v-process/DroneProject/STM32F103RET6/SLAVE_WIFI&UltraSonic/User_GPIO.c

#include "main.h"

void RCC_Configuration(void){
  
  /* Enable GPIO clock */
  RCC_APB2PeriphClockCmd(RCC_APB2Periph_GPIOA, ENABLE);
  RCC_APB2PeriphClockCmd(RCC_APB2Periph_GPIOC, ENABLE);
  RCC_APB2PeriphClockCmd(RCC_APB2Periph_GPIOD, ENABLE);
  RCC_APB2PeriphClockCmd(RCC_APB2Periph_GPIOE, ENABLE);
  RCC_APB2PeriphClockCmd(RCC_APB2Periph_GPIOB, ENABLE);
  
  /* USART clock enable */
  RCC_APB2PeriphClockCmd(RCC_APB2Periph_USART1 , ENABLE);
  RCC_APB1PeriphClockCmd(RCC_APB1Periph_USART2 , ENABLE);
  RCC_APB1PeriphClockCmd(RCC_APB1Periph_USART3 , ENABLE);
  RCC_APB1PeriphClockCmd(RCC_APB1Periph_UART4 , ENABLE);
  
  /* TIM clock enable */
  RCC_APB1PeriphClockCmd(RCC_APB1Periph_TIM3, ENABLE);
  RCC_APB1PeriphClockCmd(RCC_APB1Periph_TIM5, ENABLE);
 
  /* Enable AFIO clock */
  RCC_APB2PeriphClockCmd(RCC_APB2Periph_AFIO, ENABLE);
}

void GPIO_Configuration(void){
  
  GPIO_InitTypeDef GPIO_InitStructure;

  /* TIM Configuration*/
  /* TIM5 Channel2 - PA01, TIM3 Channel2 - PA07 */
  GPIO_InitStructure.GPIO_Pin = GPIO_Pin_1 | GPIO_Pin_7;
  GPIO_InitStructure.GPIO_Mode = GPIO_Mode_IN_FLOATING;
  GPIO_InitStructure.GPIO_Speed = GPIO_Speed_50MHz;
  GPIO_Init(GPIOA, &GPIO_InitStructure);
  
  /* LED Configuration */
  GPIO_InitStructure.GPIO_Pin = GPIO_Pin_0 | GPIO_Pin_1 | GPIO_Pin_2;
  GPIO_InitStructure.GPIO_Mode = GPIO_Mode_Out_PP;
  GPIO_InitStructure.GPIO_Speed = GPIO_Speed_50MHz;
  GPIO_Init(GPIOB, &GPIO_InitStructure);
  
  /* UltraSonic Triger Configuration */
  GPIO_InitStructure.GPIO_Pin = GPIO_Pin_5 | GPIO_Pin_8;
  GPIO_InitStructure.GPIO_Mode = GPIO_Mode_Out_PP;
  GPIO_InitStructure.GPIO_Speed = GPIO_Speed_50MHz;
  GPIO_Init(GPIOA, &GPIO_InitStructure);
  
  /* USART1 Configuration*/
  /* TX - PA09, RX - PA10 */
  GPIO_InitStructure.GPIO_Pin = GPIO_Pin_9;
  GPIO_InitStructure.GPIO_Speed = GPIO_Speed_50MHz;
  GPIO_InitStructure.GPIO_Mode = GPIO_Mode_AF_PP;         
  GPIO_Init(GPIOA, &GPIO_InitStructure);
  
  GPIO_InitStructure.GPIO_Pin = GPIO_Pin_10;
  GPIO_InitStructure.GPIO_Mode = GPIO_Mode_IN_FLOATING;               
  GPIO_Init(GPIOA, &GPIO_InitStructure);
 
  /* USART2 Configuration*/
  /* TX - PA02, RX - PA03 */
  GPIO_InitStructure.GPIO_Pin = GPIO_Pin_2;
  GPIO_InitStructure.GPIO_Speed = GPIO_Speed_50MHz;
  GPIO_InitStructure.GPIO_Mode = GPIO_Mode_AF_PP;         
  GPIO_Init(GPIOA, &GPIO_InitStructure);
  
  GPIO_InitStructure.GPIO_Pin = GPIO_Pin_3;
  GPIO_InitStructure.GPIO_Mode = GPIO_Mode_IN_FLOATING;               
  GPIO_Init(GPIOA, &GPIO_InitStructure);
  
  /* USART3 Configuration*/
  /* TX - PB10, RX - PB11 */
  GPIO_InitStructure.GPIO_Pin = GPIO_Pin_10;
  GPIO_InitStructure.GPIO_Speed = GPIO_Speed_50MHz;
  GPIO_InitStructure.GPIO_Mode = GPIO_Mode_AF_PP;         
  GPIO_Init(GPIOB, &GPIO_InitStructure);
  
  GPIO_InitStructure.GPIO_Pin = GPIO_Pin_11;
  GPIO_InitStructure.GPIO_Mode = GPIO_Mode_IN_FLOATING;               
  GPIO_Init(GPIOB, &GPIO_InitStructure);
  
  /* UART4 Configuration*/
  /* TX - PC10, RX - PC11 */
  GPIO_InitStructure.GPIO_Pin = GPIO_Pin_10;
  GPIO_InitStructure.GPIO_Speed = GPIO_Speed_50MHz;
  GPIO_InitStructure.GPIO_Mode = GPIO_Mode_AF_PP;         
  GPIO_Init(GPIOC, &GPIO_InitStructure);
  
  GPIO_InitStructure.GPIO_Pin = GPIO_Pin_11;
  GPIO_InitStructure.GPIO_Mode = GPIO_Mode_IN_FLOATING;               
  GPIO_Init(GPIOC, &GPIO_InitStructure);
}

void NVIC_Configuration(void){
  
  NVIC_InitTypeDef NVIC_InitStructure;

#ifdef  VECT_TAB_RAM  
  /* Set the Vector Table base location at 0x20000000 */ 
  NVIC_SetVectorTable(NVIC_VectTab_RAM, 0x0); 
#else  /* VECT_TAB_FLASH  */
  /* Set the Vector Table base location at 0x08000000 */ 
  NVIC_SetVectorTable(NVIC_VectTab_FLASH, 0x0);   
#endif

  NVIC_PriorityGroupConfig(NVIC_PriorityGroup_2);
  
  /* Enable the TIM3 global Interrupt */
  NVIC_InitStructure.NVIC_IRQChannel = TIM3_IRQn;
  NVIC_InitStructure.NVIC_IRQChannelPreemptionPriority = 0;
  NVIC_InitStructure.NVIC_IRQChannelSubPriority = 4;
  NVIC_InitStructure.NVIC_IRQChannelCmd = ENABLE;
  NVIC_Init(&NVIC_InitStructure);
    
  /* Enable the TIM3 global Interrupt */
  NVIC_InitStructure.NVIC_IRQChannel = TIM5_IRQn;
  NVIC_InitStructure.NVIC_IRQChannelPreemptionPriority = 0;
  NVIC_InitStructure.NVIC_IRQChannelSubPriority = 5;
  NVIC_InitStructure.NVIC_IRQChannelCmd = ENABLE;
  NVIC_Init(&NVIC_InitStructure);

  /* Enable the USART2 Interrupt */
  NVIC_InitStructure.NVIC_IRQChannel = USART2_IRQn;
  NVIC_InitStructure.NVIC_IRQChannelSubPriority = 3;
  NVIC_InitStructure.NVIC_IRQChannelCmd = ENABLE;
  NVIC_Init(&NVIC_InitStructure);
  
  /* Enable the USART3 Interrupt */
  NVIC_InitStructure.NVIC_IRQChannel = USART3_IRQn;
  NVIC_InitStructure.NVIC_IRQChannelSubPriority = 1;
  NVIC_InitStructure.NVIC_IRQChannelCmd = ENABLE;
  NVIC_Init(&NVIC_InitStructure);
  
  /* Enable the USART4 Interrupt */
  NVIC_InitStructure.NVIC_IRQChannel = UART4_IRQn;
  NVIC_InitStructure.NVIC_IRQChannelSubPriority = 3;
  NVIC_InitStructure.NVIC_IRQChannelCmd = ENABLE;
  NVIC_Init(&NVIC_InitStructure);  
}

  
  
  
  
