v-process/DroneProject/STM32F103RET6/SLAVE_WIFI&UltraSonic/User_Timer.c

#include "main.h"



void TIM_Configuration(void){
  
  TIM_ICInitTypeDef  TIM_ICInitStructure;
  TIM_TimeBaseInitTypeDef  TIM_TimeBaseStructure;
  
  /* TIM3 configuration: PWM Input mode ------------------------
     The external signal is connected to TIM3 CH2 pin (PA.01), 
     The Rising edge is used as active edge,
     The TIM3 CCR2 is used to compute the frequency value 
     The TIM3 CCR1 is used to compute the duty cycle value
  ------------------------------------------------------------ */
  
  /* Time Base configuration */
  TIM_TimeBaseStructure.TIM_Prescaler = 32;
  TIM_TimeBaseStructure.TIM_CounterMode = TIM_CounterMode_Up;
  TIM_TimeBaseStructure.TIM_Period = PREIOD;
  TIM_TimeBaseStructure.TIM_ClockDivision = 0;
  TIM_TimeBaseStructure.TIM_RepetitionCounter = 0;

  TIM_TimeBaseInit(TIM3, &TIM_TimeBaseStructure);
  TIM_TimeBaseInit(TIM5, &TIM_TimeBaseStructure);
  
  TIM_ICInitStructure.TIM_Channel = TIM_Channel_2;
  TIM_ICInitStructure.TIM_ICPolarity = TIM_ICPolarity_Rising;
  TIM_ICInitStructure.TIM_ICSelection = TIM_ICSelection_DirectTI;
  TIM_ICInitStructure.TIM_ICPrescaler = TIM_ICPSC_DIV1;
  TIM_ICInitStructure.TIM_ICFilter = 0x0;

  TIM_PWMIConfig(TIM3, &TIM_ICInitStructure);
  TIM_PWMIConfig(TIM5, &TIM_ICInitStructure);

  /* Select the TIM3 Input Trigger: TI2FP2 */
  TIM_SelectInputTrigger(TIM3, TIM_TS_TI2FP2);
  TIM_SelectInputTrigger(TIM5, TIM_TS_TI2FP2);

  /* Select the slave Mode: Reset Mode */
  TIM_SelectSlaveMode(TIM3, TIM_SlaveMode_Reset);
  TIM_SelectSlaveMode(TIM5, TIM_SlaveMode_Reset);

  /* Enable the Master/Slave Mode */
  TIM_SelectMasterSlaveMode(TIM3, TIM_MasterSlaveMode_Enable);
  TIM_SelectMasterSlaveMode(TIM5, TIM_MasterSlaveMode_Enable);

  /* TIM enable counter */
  TIM_Cmd(TIM3, ENABLE);
  TIM_Cmd(TIM5, ENABLE);

  /* Enable the CC2 & CC3 Interrupt Request */
  TIM_ITConfig(TIM3, TIM_IT_CC2, ENABLE);
  TIM_ITConfig(TIM5, TIM_IT_CC2, ENABLE);
}

void delay_us(int cnt)
{
  int i;
  for(; cnt!=0; cnt--)
  {
    for(i=0;i<7;i++) asm("NOP"); 
  }
}
void delay_ms(int cnt)
{
  for(; cnt!=0; cnt--)
  {
    delay_us(950);
  }
}
