v-process/DroneProject/(commit log)

2015-10-01 와이파이 ssid를 비교하여 기능 수행 및 구글맵 연동하여 목적지 위,경도 출력
2015-10-05 구글맵 조이스틱 결합
2015-10-05 드론 위아래회전역할/앞뒤양옆 이동을 위한 조이스틱 추가
2015-10-06 타이틀, 버튼으로 ap설정 확인
2015-10-13 현재위치 받아와서 구글맵상 표시, 현재위치 마커 변경
2015-10-23 PID 제어를 위한 모니터링앱(레이아웃)
2015-10-29 패킷 나눠서 데이터 받기
2015-10-30 PID 연동
2015-10-30 소켓서버 패킷 나눠 전송
2015-11-01 pid기능 앱 기능 완성
2015-11-07 Height값 받고 조이스틱추가 및 주기적으로 통신값 보내기
2015-11-07 Angle값 sin, cos값 변환 후 전송하도록 수정
2015-11-18 STM32F103RET6 삭제
